DBBEN/KiCad-Symbol-Libraries/Draft/RJ45_21171_Shopee.DXF

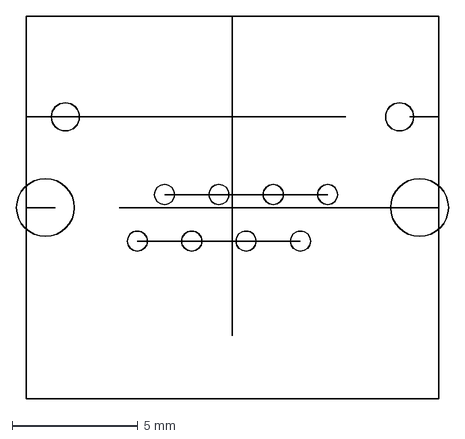
[picture p2: CAD file, 2024-06-27]
Draft/RJ45_21171_Shopee.DXF
17.2 x 15.2 mm
