DBBEN/KiCad-Symbol-Libraries/Models/User Library-RJ12_54601-906WPLF.step

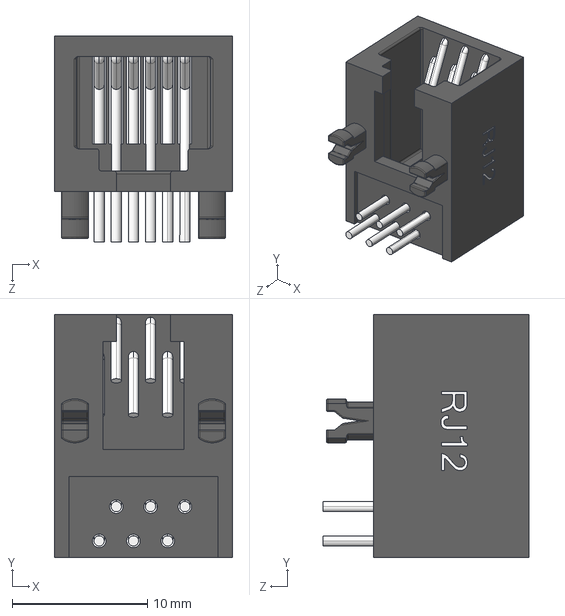
[picture p3: CAD file, 2024-02-03]
Models/User Library-RJ12_54601-906WPLF.step
13.2 x 18.0 x 15.2 mm
