DBBEN/KiCad-Symbol-Libraries/Models/User Library-ATGM336H.STEP

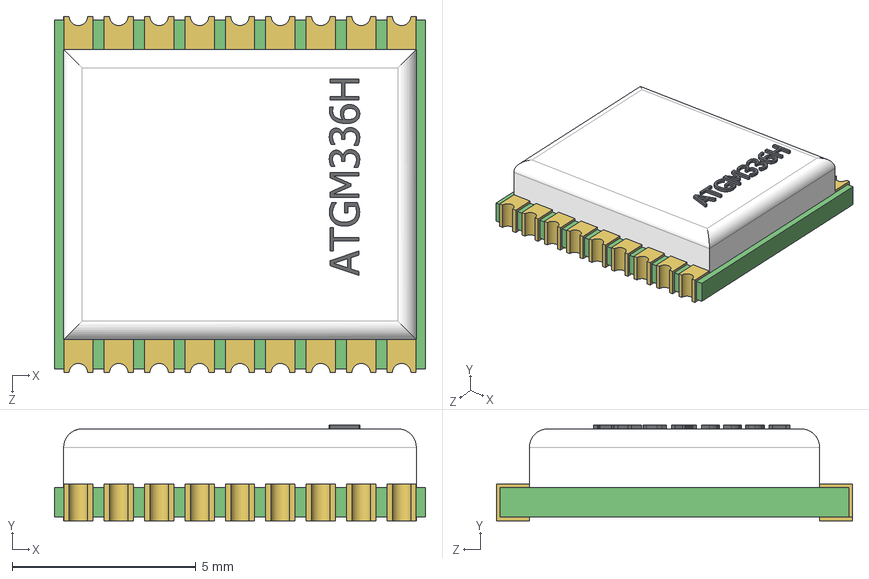
[picture p4: CAD file, 2024-02-03]
Models/User Library-ATGM336H.STEP
10.1 x 2.60 x 9.70 mm
