DBBEN/KiCad-Symbol-Libraries/Models/SOT523.STEP

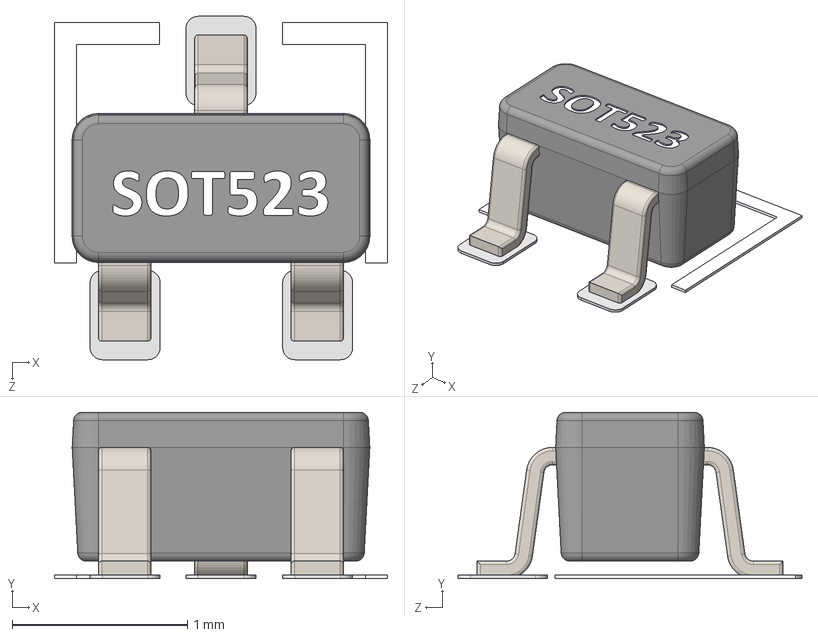
[picture p5: CAD file, 2023-11-02]
Models/SOT523.STEP
1.90 x 0.95 x 1.96 mm
