DBBEN/KiCad-Symbol-Libraries/Models/3 PIN DG306-5 BLUE - PITCH 5 mm.stp

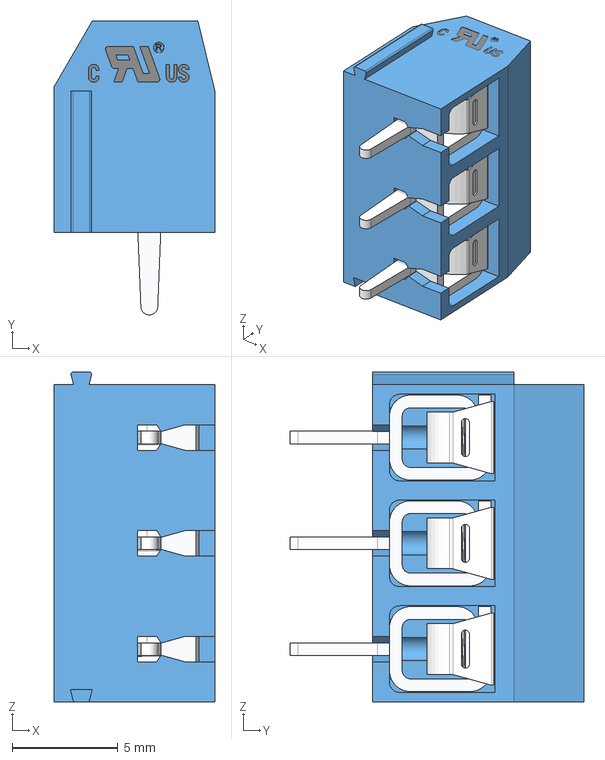
[picture p6: CAD file, 2023-10-31]
Models/3 PIN DG306-5 BLUE - PITCH 5 mm.stp
7.60 x 13.9 x 15.6 mm
