DBBEN/KiCad-Symbol-Libraries/Models/3x4x2mm - 2 Pad.stp

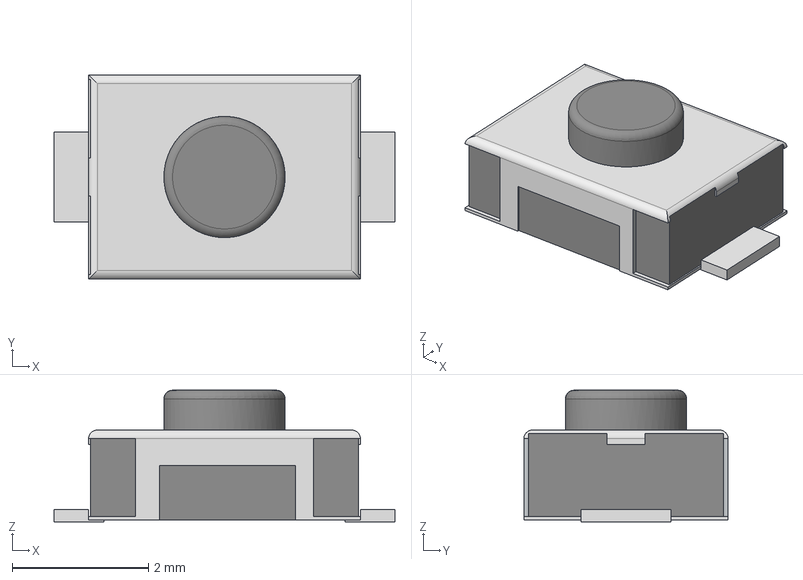
[picture p7: CAD file, 2023-06-21]
Models/3x4x2mm - 2 Pad.stp
5.00 x 3.00 x 1.93 mm
