DBBEN/KiCad-Symbol-Libraries/Models/ASTX - ASVTX.STEP

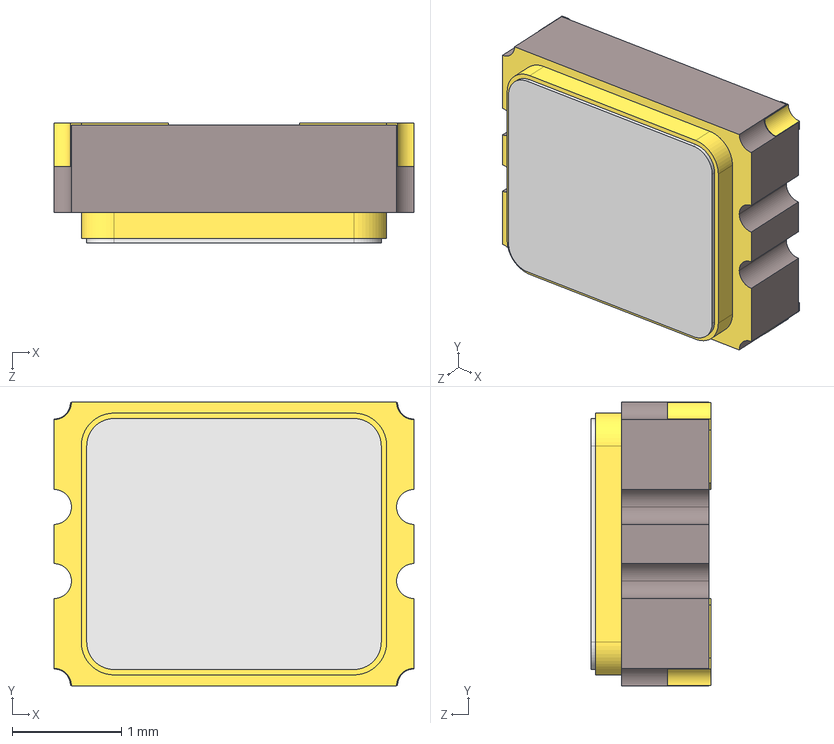
[picture p8: CAD file, 2023-06-21]
Models/ASTX - ASVTX.STEP
3.30 x 2.60 x 1.10 mm
ASTX_Pad
ASTX_Pad001
ASTX_Pad002
ASTX_ComponentPads
