DBBEN/KiCad-Symbol-Libraries/Models/Inductor_SMD_AMPLF_0530.STEP

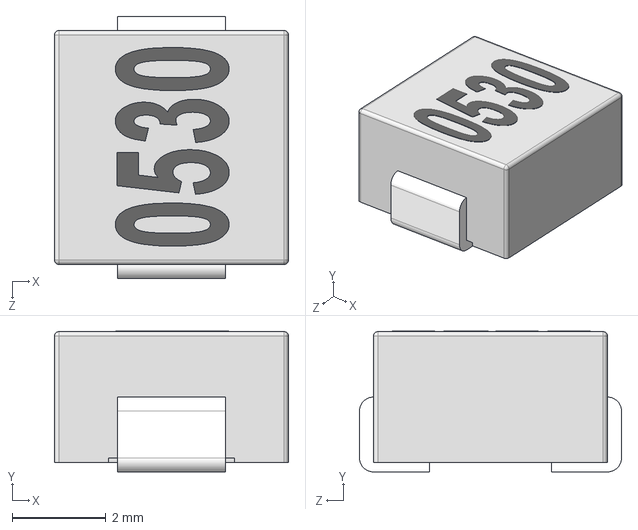
[picture p9: CAD file, 2023-06-15]
Models/Inductor_SMD_AMPLF_0530.STEP
5.00 x 3.01 x 5.60 mm
