DBBEN/KiCad-Symbol-Libraries/Models/2 PIN DG306-5 BLUE - PITCH 5 mm.stp

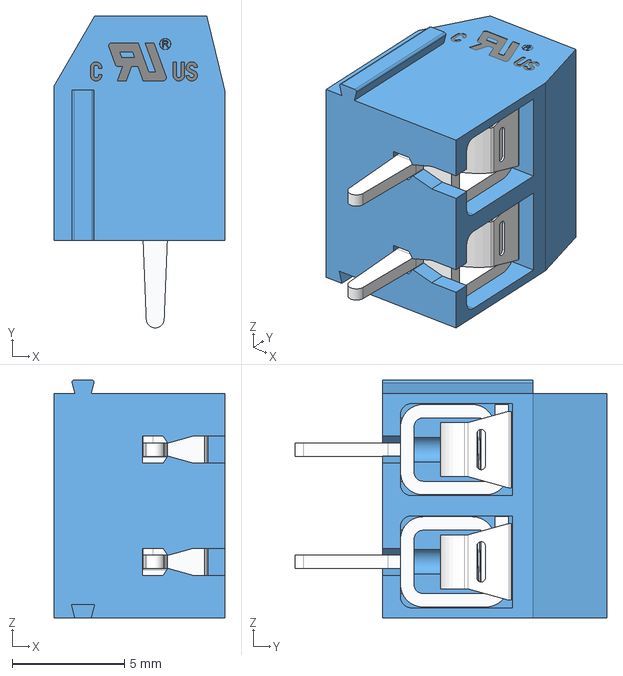
[picture p10: CAD file, 2023-06-15]
Models/2 PIN DG306-5 BLUE - PITCH 5 mm.stp
7.60 x 13.9 x 10.6 mm
