DBBEN/KiCad-Symbol-Libraries/Models/A9G.IGS

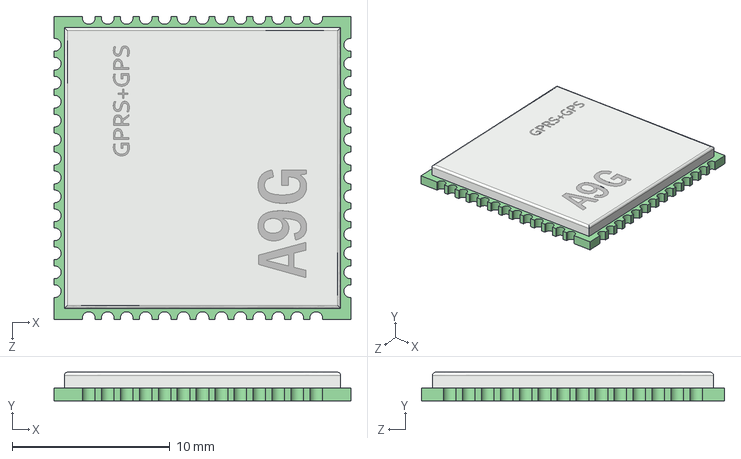
[picture p11: CAD file, 2023-06-15]
Models/A9G.IGS
18.8 x 1.81 x 19.2 mm
