DBBEN/KiCad-Symbol-Libraries/Models/E32-433T20S--3DModel-STEP-56544.STEP

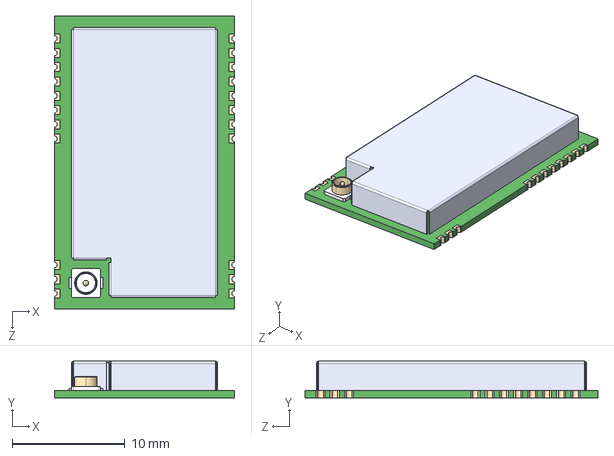
[picture p12: CAD file, 2023-06-15]
Models/E32-433T20S--3DModel-STEP-56544.STEP
16.0 x 3.25 x 26.0 mm
