DBBEN/KiCad-Symbol-Libraries/Models/L_12x12mm_H8mm.step

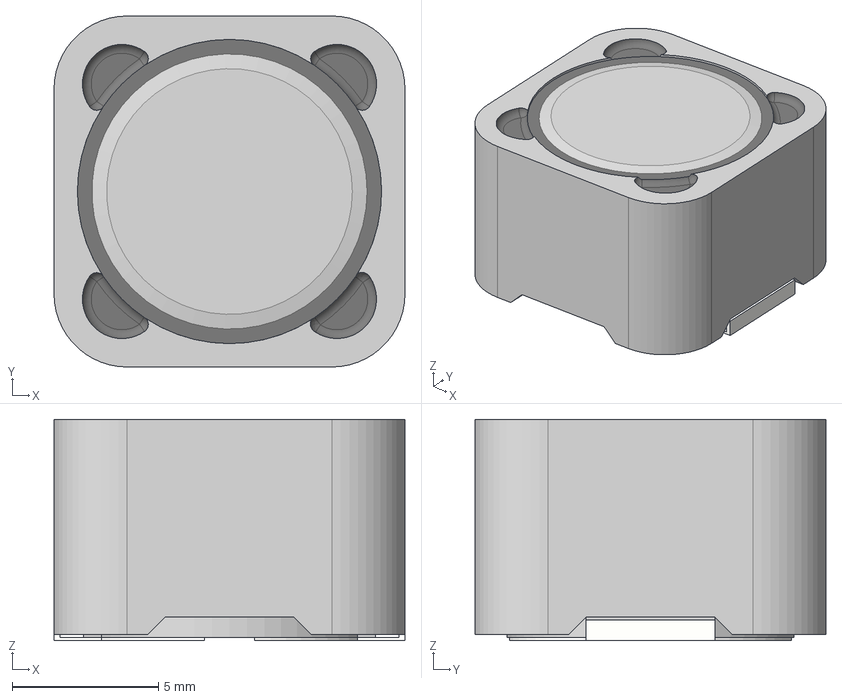
[picture p13: CAD file, 2023-06-15]
Models/L_12x12mm_H8mm.step
12.0 x 12.0 x 7.56 mm
