DBBEN/KiCad-Symbol-Libraries/Models/Inductor_SMD_AMPLF_0630.STEP

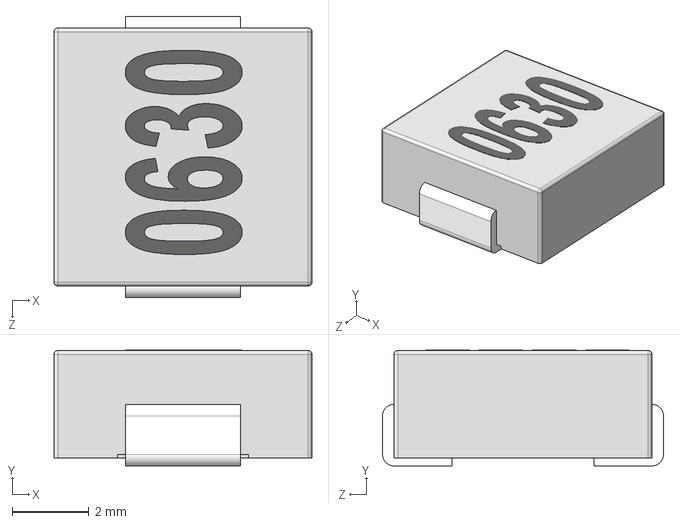
[picture p14: CAD file, 2023-06-15]
Models/Inductor_SMD_AMPLF_0630.STEP
6.70 x 3.01 x 7.30 mm
