DBBEN/KiCad-Symbol-Libraries/(list of files, cad)

Other CAD files:
Draft/1-3 OLED with EC11 Rotary Encoder.SLDPRT
Draft/WT32_Outline.SLDPRT
Draft/TP4056_StepUp.SLDPRT
Draft/1-3 OLED with EC11 Rotary Encoder.DXF
Draft/TP4056_StepUp.DXF
Draft/WT32_Outline.DXF
Models/60311002114501.stp
Models/691242710005.stp
Models/691242710010.stp
