DBBEN/KiCad-Symbol-Libraries/(commit log)

2023-06-15 Footprint Initial Commit
2023-06-15 3D Models Initial Commit
    [2 PIN DG306-5 BLUE - PITCH 5 mm.stp, 60311002114501.stp, 691242710005.stp, 691242710010.stp, A9G.IGS, E32-433T20S--3DModel-STEP-56544.STEP, Inductor_SMD_AMPLF_0530.STEP, Inductor_SMD_AMPLF_0630.STEP]
2023-06-20 Renaming of files
    [2 PIN DG306-5 BLUE - PITCH 5 mm.stp, 60311002114501.stp, 691242710005.stp, 691242710010.stp, A9G.IGS, E32-433T20S--3DModel-STEP-56544.STEP, Inductor_SMD_AMPLF_0530.STEP, Inductor_SMD_AMPLF_0630.STEP]
2023-06-20 New Parts
    - Added QFN Package for ESP32-S2
    - ESP32-S2 Symbol
2023-06-20 Added Espressif Library
    - Added Espressif Library
    - Programmer Connector Revision
2023-06-21 Additional Models & Symbol Changes
    [3x4x2mm - 2 Pad.stp, ASTX - ASVTX.STEP]
2023-06-22 ESP32-WROOM Label Resize
2023-06-22 ESP32 3D Model Opacity Change
2023-07-01 Added 3P Terminal Block
    [3 PIN DG306-5 BLUE - PITCH 5 mm.stp]
2023-07-24 Added TP4056+Step Up Module
    [TP4056_StepUp.DXF, TP4056_StepUp.SLDPRT]
2023-07-27 WT32 Adjustment
    [WT32_Outline.DXF, WT32_Outline.SLDPRT]
2023-10-31 New Footprint
    ESP32 Module 38 Pin
2023-11-02 Added SOT523
    [SOT523.STEP]
2023-11-30 Added ESP32-WROOM 30-pin module
2023-11-30 Added RTC & GPS symbol & footprints
2023-12-01 ESP32 correction
2024-02-03 ATGM336H GPS Module
    [User Library-ATGM336H.STEP]
2024-02-03 RJ12 Model
    [User Library-RJ12_54601-906WPLF.step]
2024-02-07 Dual P-Channel MOSFET
2024-06-10 Added EasyEDA to KiCad Library
2024-06-13 Add: CR2032 Battery Holder
2024-06-27 RJ45 21171 Shopee
    [RJ45_21171_Shopee.DXF]
2024-06-28 Module Footprints
2024-07-16 SMD Connectors
2024-07-18 USB B Connector
2024-07-20 10 Pin Terminal Block
2024-07-29 Added connectors
2024-08-10 Addtl Connectors
2024-08-13 HDGC 12P Connector
2024-09-02 Relay Pin Number
2024-09-16 MCU Catergory easyeda2kicad
    [QFN-48-1EP_5x5mm_P0.35mm_EP3.7x3.7mm.step]
2024-09-18 Updated ESP32-MINI-1U
2024-09-23 Easyeda2kicad Connectors
2024-11-14 Added Switches
2024-11-29 5-Pin JST XH SMD Connector
2024-11-30 Added Straight RJ45 Jack + OLED I2C and EC11
    [1-3 OLED with EC11 Rotary Encoder.DXF, 1-3 OLED with EC11 Rotary Encoder.SLDPRT]
2024-12-01 Added XH SMD Connectors
2024-12-02 Added Side Buttons
2024-12-03 Added LEDs
2024-12-05 E220 Unconnected Pin
2024-12-05 Added 3A Fuse
2024-12-09 Added SMD XH Connector
2025-01-08 A4988 Stepper Motor Driver IC
2025-01-10 Added ESP32-WROOM-32UE & 3D Model dir
2025-02-10 MAX30102 Sensor
2025-04-16 100uF Capacitor
2025-04-21 L9110 Motor Drivers
2025-09-05 Inductor & MOSFET
2025-09-08 Add Capacitor
2026-05-30 Drop Sensor
2026-10-14 Inverted F Antenna & others
2026-10-19 Connector & Switch
