DBBEN/KiCad-Symbol-Libraries/(notices)

Notices in the files:
Models/QFN-48-1EP_5x5mm_P0.35mm_EP3.7x3.7mm.step:
Copyright (C) 2018, kicad StepUp
This work is licensed under the [Creative Commons CC-BY-SA 4.0 License](https://creativecommons.org/licenses/by-sa/4.0/legalcode),
with the following exception:
To the extent that the creation of electronic designs that use 'Licensed Material' can be considered to be 'Adapted Material',
You are free to use the library data in your own projects without the obligation to share your project files under this or any other license agreement.
